rohith8988/autonomous_rc_car/Hardware/Electronics/version_1/RC_Car_Electrical_Diagram.png

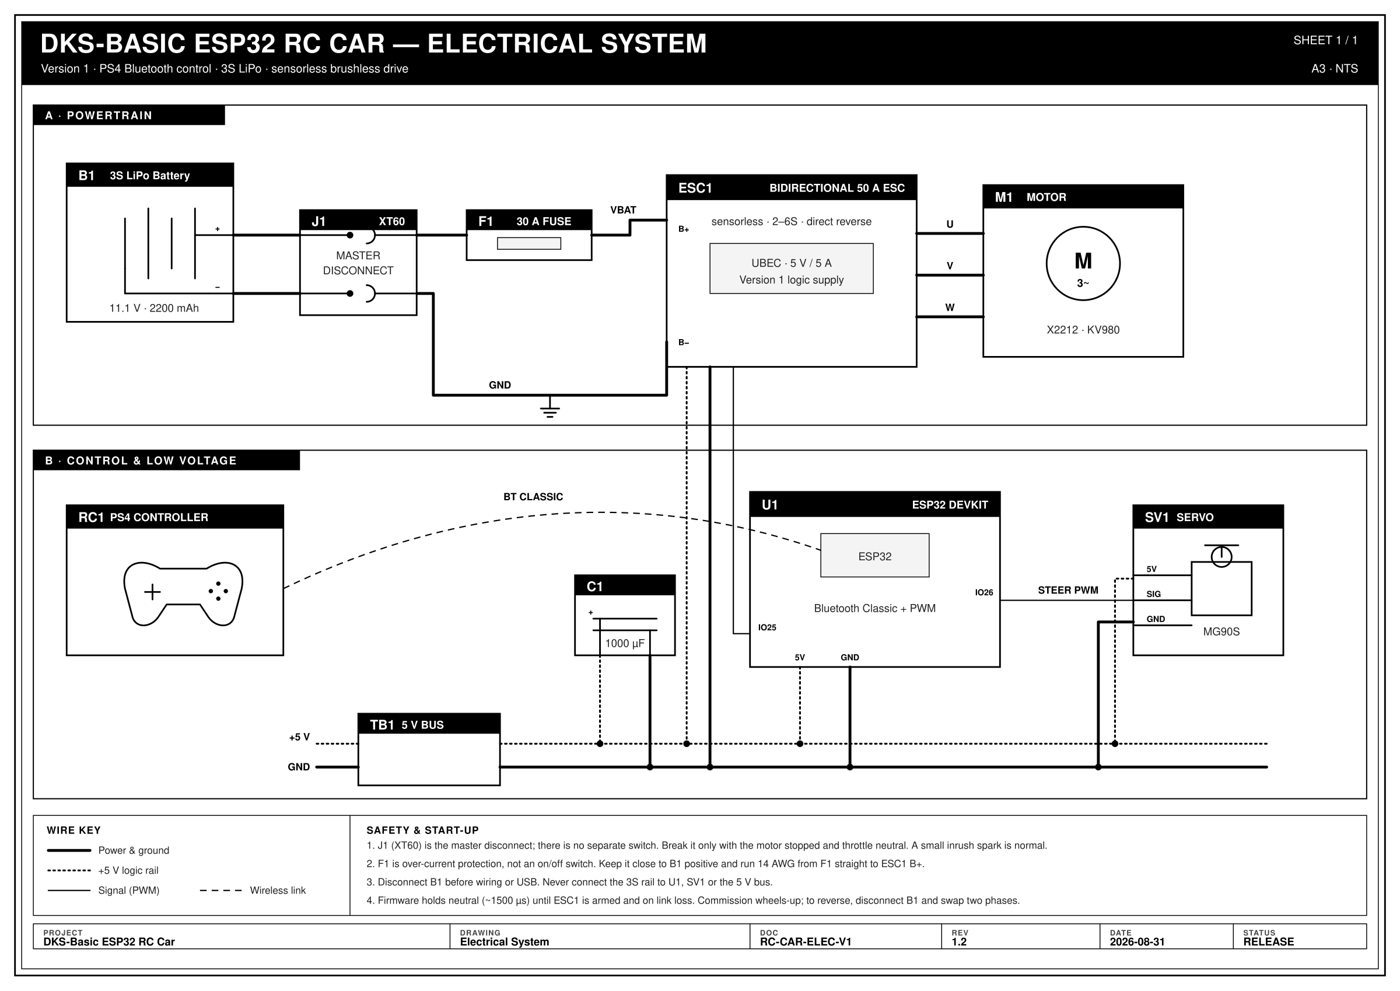
Hardware/Electronics/version_1/RC_Car_Electrical_Diagram.png
