rohith8988/autonomous_rc_car/Hardware/Mechanical/Motor_Specifications/drawing.png

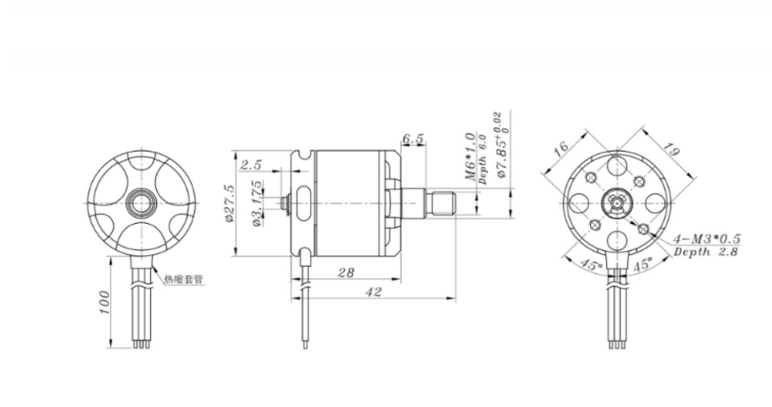
Hardware/Mechanical/Motor_Specifications/drawing.png
