rohith8988/autonomous_rc_car/Hardware/Electronics/version_1/BOM.csv

Reference | Quantity | Part | Specification | Status | Preferred Store | Listed Price INR | Product Link | Price Checked | Notes
B1 | 1 | LiPo battery | Pro-Range 3S 2200 mAh 30C; 11.1 V nominal; XT60 discharge connector | Bought | Robu.in | 1619 | https://robu.in/product-category/3-cell-lipo-11-1v-12-6v/ | 2026-08-27 | 12.6 V maximum when fully charged; exact Robu SKU 23741
F1 | 1 kit | Inline fuse and holder | 30 A ATC/ATO blade fuse; waterproof holder; 12 AWG leads; 10-set kit | Need to buy | Amazon.in | 1700 | https://www.amazon.in/dp/B0BNGP7PQR | 2026-08-27 | Install close to battery positive. Over-current protection only, never an on/off switch. Selected because the Robu holder found was rated only 25 A
ESC1 | 1 | Bidirectional brushless ESC | Robu SKU 1345166; 50 A class; 2-6S; 5 V/5 A UBEC; sensorless | Need to buy | Robu.in | 1270 | https://robu.in/product/bidirectional-50a-2-6s-ubec-5a-5v | 2026-08-27 | Integrated UBEC is the sole 5 V source
M1 | 1 | Brushless motor | SunnySky X2212-13 KV980 CW; sensorless three phase | Bought | Robu.in | N/A | https://robu.in/product/sunny-sky-x-fixed-wing-series-iii-motor-x2212-iii-980kv | 2026-08-27 | Reference link for the owned motor; mounted with the custom cylindrical rear frame
U1 | 1 | ESP32 development board | ESP32-WROOM-32 38-pin board with Bluetooth Classic; 5 V/VIN input | Bought | Robu.in | N/A | https://robu.in/product/esp32-38pin-development-board-wifibluetooth-ultra-low-power-consumption-dual-core/ | 2026-08-27 | Reference link for the owned board; GPIO25 throttle and GPIO26 steering
SV1 | 1 | Steering servo | TowardPro MG90S mini digital servo; 180-degree; 4.8-6 V | Bought | Robu.in | N/A | https://robu.in/product-category/towerpro-servo-motor/ | 2026-08-27 | Reference link for the owned servo; powered at 5 V
C1 | 1 | Electrolytic capacitor | 1000 uF; 16-25 V; radial; low-ESR / low-impedance; 105 C. Preferred sub: Nichicon UHV1C102MPD (16 V). Original UPW1A102MPD6TD (10 V) is out of stock at Robu | Need to buy | Robu.in | Check live price | https://robu.in/product/uhv1c102mpd-nichicon-1000uf-16v-30m%CF%89-%C2%B120-1-089a120hz-plugind10xl16mm-aluminum-electrolytic-capacitors-leaded-rohs/ | 2026-08-27 | 16-25 V preferred over 10 V on the 5 V rail. Mount at the 5 V distribution point; observe polarity. Verify live stock. Alt: Evelta 1000uF 16V https://evelta.com/1000uf-16v-electrolytic-capacitor/ | element14 IN Nichicon UHE1C102MPD1TD https://in.element14.com/nichicon/uhe1c102mpd1td/aluminum-electrolytic-capacitor/dp/1823631 | Mouser Panasonic EEU-FR1C102 https://www.mouser.com/ProductDetail/Panasonic/EEU-FR1C102
TB1 | 2 | Five-way lever connector | WAGO 221-415 (5-conductor, 0.2-4 mm2); one for +5 V and one for GND. 221-414 (4-way) also sufficient | Need to buy | Amazon.in | Check live price | https://www.amazon.in/WAGO-221-415-Lever-Nuts-5-Conductor-Connectors/dp/B07WC2XBMK | 2026-08-27 | Out of stock at Robu. Amazon listing is a box of 25. Separate insulated 5 V and common-ground distribution points. Alt: Flipkart https://www.flipkart.com/wago-221-415-connectors-wire-connector/p/itm1a498ee59abb4 | WAGO India https://www.wago.com/in/installation-terminal-blocks-and-connectors/splicing-connector-with-levers/p/221-415
J1 | 1 | XT60 battery pigtail (master disconnect) | Amass XT60 male with 14 AWG silicone wire, ~15 cm (SafeConnect original is out of stock at Robu) | Need to buy | Quartz Components | Check live price | https://quartzcomponents.com/products/xt60-male-connector-with-14awg-silicone-wire | 2026-08-27 | Master disconnect for the car. SW1 is bypassed, so this is the only way to isolate B1: mate or break it with the motor stopped and throttle neutral, never under load. A small inrush spark on connection is normal as the ESC capacitors charge; fit an anti-spark XT90-S if it becomes significant. Accepts the loss of a quickly reachable emergency cutoff. Mates with the battery XT60 female; confirm polarity with a multimeter before soldering; use genuine Amass not clones. Alt: solder-your-own from an Amass XT60 pair https://robocraze.com/products/xt60-connector-pair using W1R/W1B wire | Amazon.in https://www.amazon.in/Robocraze-XT60-Male-connector-pack/dp/B0DPZDLKY4
J2M-J4M | 3 | Motor phase male connectors | Amass GC3510-M; 3.5 mm gold-plated bullet connectors | Need to buy | Robu.in | Check live price | https://robu.in/product/amass-3-5mm-bullet-male-connector-gc3510-m/ | 2026-08-27 | Buy only if neither the motor nor ESC already includes the required male side. Evelta sells male+female together: https://evelta.com/3-5mm-gold-plated-bullet-male-female-banana-connector/ | RC Mumbai 5-pair: https://rcmumbai.com/bullet-connector-3-5mm.html
J2F-J4F | 3 | Motor phase female connectors | Amass GC3510-F; 3.5 mm gold-plated bullet connectors | Need to buy | Robu.in | Check live price | https://robu.in/product/amass-3-5mm-bullet-female-connector-gc3510-f/ | 2026-08-27 | Buy only if neither the motor nor ESC already includes the required female side; fully cover with heat-shrink. Evelta male+female set: https://evelta.com/3-5mm-gold-plated-bullet-male-female-banana-connector/
W1R | 1 m | High-current red wire | 14 AWG flexible stranded silicone wire; red | Need to buy | Robu.in | 66 | https://robu.in/?s=R179509&post_type=product | 2026-08-27 | Battery positive harness: B1 to F1, then 14 AWG from F1 straight to ESC1 B+
W1B | 1 m | High-current black wire | 14 AWG flexible stranded silicone wire; black | Need to buy | Robu.in | 56 | https://robu.in/?s=R179508&post_type=product | 2026-08-27 | Battery-negative and high-current return wiring
W2 | 1 m | Low-voltage three-core wire | 22 AWG flexible silicone cable; red black and green cores; Robu SKU R257312 | Need to buy | Robu.in | 69 | https://robu.in/?s=R257312&post_type=product | 2026-08-27 | For short 5 V ground and signal harnesses
H1 | 1 kit | Heat-shrink tubing | 328-piece flame-retardant polyolefin assortment; 2:1 shrink ratio; 1-14 mm sizes | Need to buy | Robu.in | 159 | https://robu.in/?s=R256576&post_type=product | 2026-08-27 | No conductive connector or solder joint may remain exposed
H2 | 1 pack | Cable ties | Nylon cable ties; 100 mm x 2.5 mm; pack of 100 | Need to buy | Robu.in | 30 | https://robu.in/product-category/cable-ties/ | 2026-08-27 | Use for harness bundling and strain relief
H3 | 1 pack | Adhesive cable-tie mounts | Immech nylon self-adhesive mounts; 19 x 19 mm; pack of 100 | Need to buy | Amazon.in | 194 | https://www.amazon.in/dp/B091GG934H | 2026-08-27 | Clean the mounting surface with isopropyl alcohol before applying
