rohith8988/autonomous_rc_car/Hardware/Mechanical/RC_Car_Assembly.FCStd

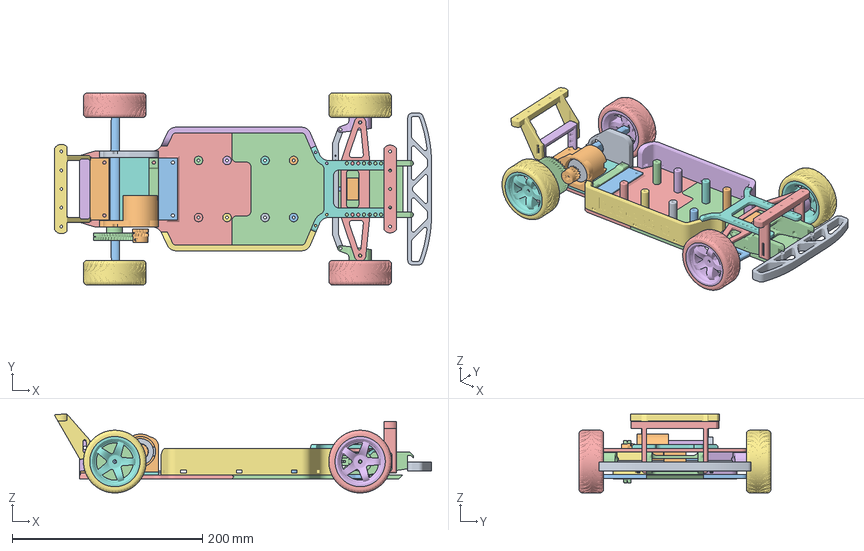
[picture p6: CAD file, 2026-09-17]
Hardware/Mechanical/RC_Car_Assembly.FCStd
396.5 x 202.0 x 83.0 mm
motor_link_body
servo_link_body
servo_horn_body
Standoff_1
Standoff_2
Standoff_3
Standoff_4
Standoff_5
Standoff_6
Standoff_7
Standoff_8
DKS-Basic_DukeDoks_Chassis-1
DKS-Basic_DukeDoks_Chassis-2_A
DKS-Basic_DukeDoks_Body_L
DKS-Basic_DukeDoks_Body_R
DKS-Basic_DukeDoks_Front-Bars
DKS-Basic_DukeDoks_Bumper
DKS-Basic_DukeDoks_Rear-Flex-1
DKS-Basic_DukeDoks_Rear-Flex-2
DKS-Basic_DukeDoks_Clamp
DKS-Basic_DukeDoks_Front-Case-Holder
DKS-Basic_DukeDoks_Clamp-Case-Holder
DKS-Basic_DukeDoks_Rear-Case-Holder
DKS-Basic_DukeDoks_Rear-Frame-Lower
DKS-Basic_DukeDoks_Rear-Frame_L
X2212_Rear_Frame_A_OnePiece
DKS-Basic_DukeDoks_Front-Bars-Lower
DKS-Basic_DukeDoks_A_Front-Frame
DKS-Basic_DukeDoks_A_Front-Bars-Upper
DKS-Basic_DukeDoks_Wheel-Hub_mirrored
DKS-Basic_DukeDoks_Basic-Wheel-01-Tire
DKS-Basic_DukeDoks_Basic-Wheel-01-Wheel
DKS-Basic_DukeDoks_Wheel-Axis
DKS-Basic_DukeDoks_Wheel-Axis001
DKS-Basic_DukeDoks_Wheel-Axis-Nut
DKS-Basic_DukeDoks_Wheel-Hub
DKS-Basic_DukeDoks_Basic-Wheel-01-Tire001
DKS-Basic_DukeDoks_Basic-Wheel-01-Wheel001
DKS-Basic_DukeDoks_Wheel-Axis_mirrored
DKS-Basic_DukeDoks_Wheel-Axis_mirrored001
DKS-Basic_DukeDoks_Wheel-Axis-Nut001
X2212_Smooth_Herringbone_Gear_1_14T_M3_Clamp
DKS-Basic_DukeDoks_Rear-Axis
X2212_Smooth_Herringbone_Gear_2_42T
DKS-Basic_DukeDoks_Basic-Wheel-01-Tire002
DKS-Basic_DukeDoks_Basic-Wheel-01-Wheel002
DKS-Basic_DukeDoks_Basic-Wheel-01-Tire003
DKS-Basic_DukeDoks_Basic-Wheel-01-Wheel003
DKS-Basic_DukeDoks_A_Steering
