rohith8988/autonomous_rc_car/Hardware/Mechanical/Deck/Sensor_Deck.stl

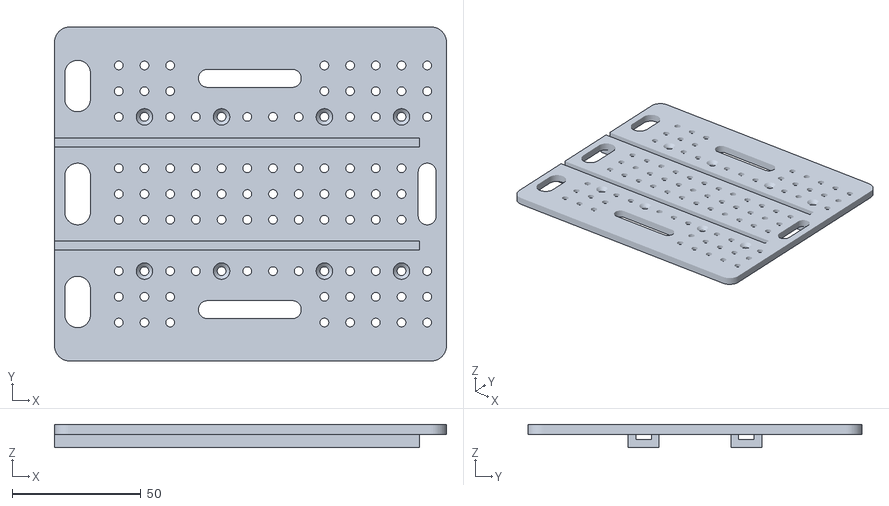
[picture p7: CAD file, 2026-09-17]
Hardware/Mechanical/Deck/Sensor_Deck.stl
152.5 x 130.0 x 9.00
