rohith8988/autonomous_rc_car/Hardware/Mechanical/DKS_Basic_Chassis/STL/DKS-Basic_DukeDoks_Bumper.stl

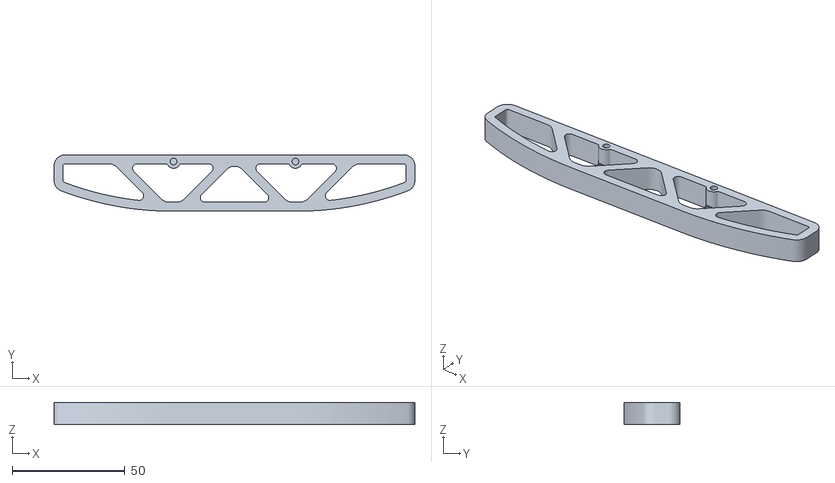
[picture p8: CAD file, 2026-08-24]
Hardware/Mechanical/DKS_Basic_Chassis/STL/DKS-Basic_DukeDoks_Bumper.stl
160.0 x 25.0 x 9.90
