rohith8988/autonomous_rc_car/Hardware/Mechanical/DKS_Basic_Chassis/STL/Front Frame A/DKS-Basic_DukeDoks_A_Steering.stl

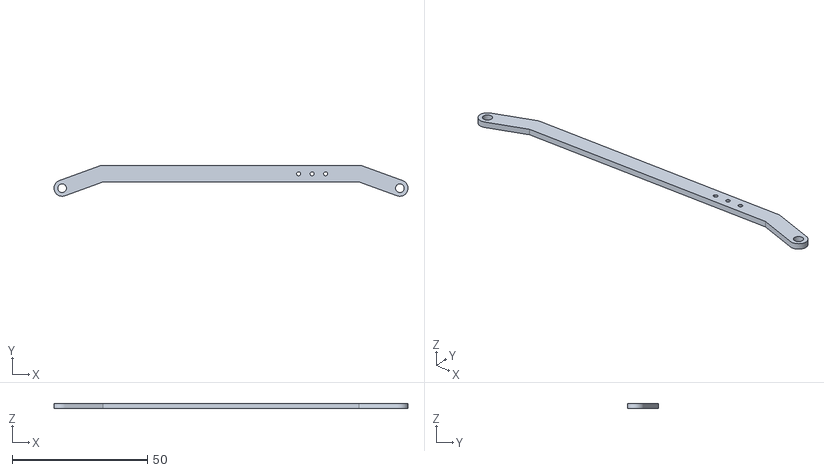
[picture p9: CAD file, 2026-08-24]
Hardware/Mechanical/DKS_Basic_Chassis/STL/Front Frame A/DKS-Basic_DukeDoks_A_Steering.stl
131.0 x 11.3 x 2.00
