rohith8988/autonomous_rc_car/Hardware/Mechanical/DKS_Basic_Chassis/STL/Front Frame B/DKS-Basic_DukeDoks_B_Front-Bars-Upper_L.stl

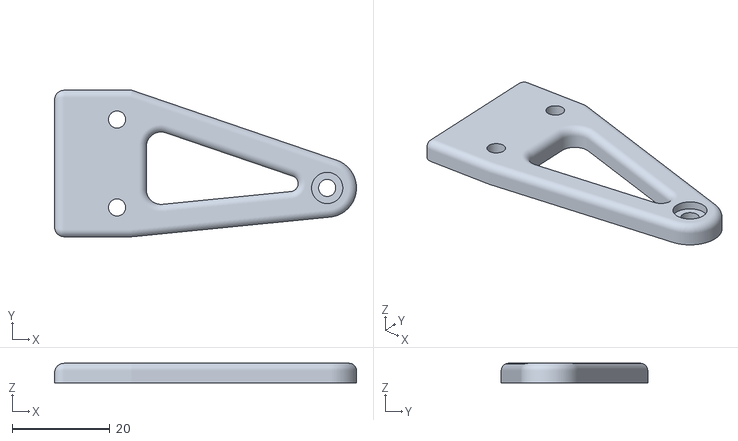
[picture p10: CAD file, 2026-08-24]
Hardware/Mechanical/DKS_Basic_Chassis/STL/Front Frame B/DKS-Basic_DukeDoks_B_Front-Bars-Upper_L.stl
61.8 x 30.0 x 4.00
