rohith8988/autonomous_rc_car/Hardware/Mechanical/Custom_Motor_Mount/output/X2212_Rear_Frame_A_OnePiece.stl

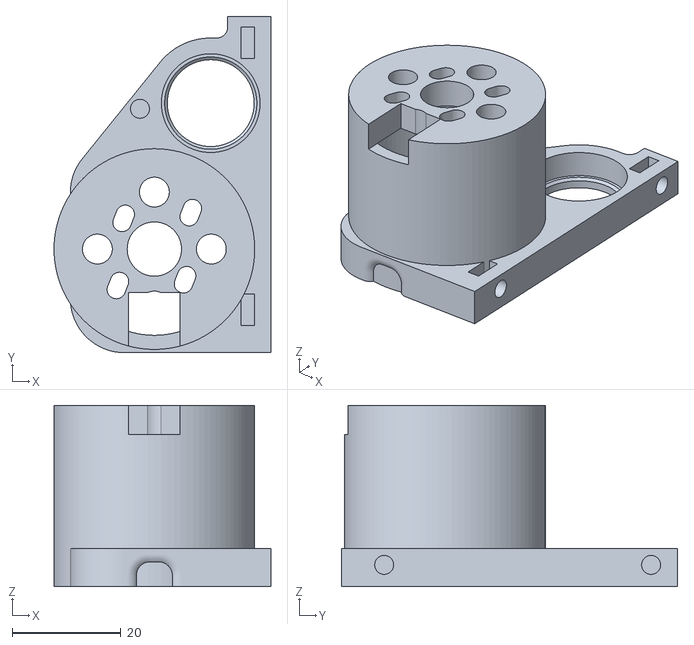
[picture p11: CAD file, 2026-08-24]
Hardware/Mechanical/Custom_Motor_Mount/output/X2212_Rear_Frame_A_OnePiece.stl
40.0 x 62.0 x 33.4
