rohith8988/autonomous_rc_car/Hardware/Mechanical/DKS_Basic_Chassis/STL/DKS-Basic_DukeDoks_Gear-2.stl

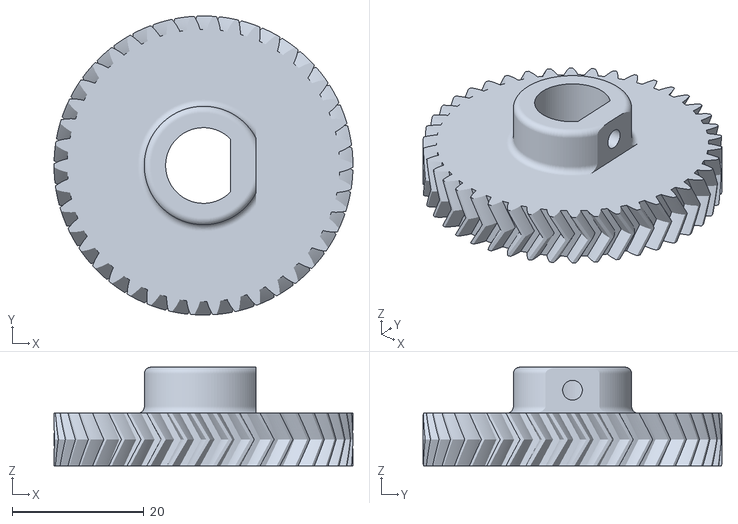
[picture p12: CAD file, 2026-08-24]
Hardware/Mechanical/DKS_Basic_Chassis/STL/DKS-Basic_DukeDoks_Gear-2.stl
45.4 x 45.4 x 15.0
