rohith8988/autonomous_rc_car/Hardware/Mechanical/DKS_Basic_Chassis/STL/Front Frame A/DKS-Basic_DukeDoks_A_Front-Bars-Upper.stl

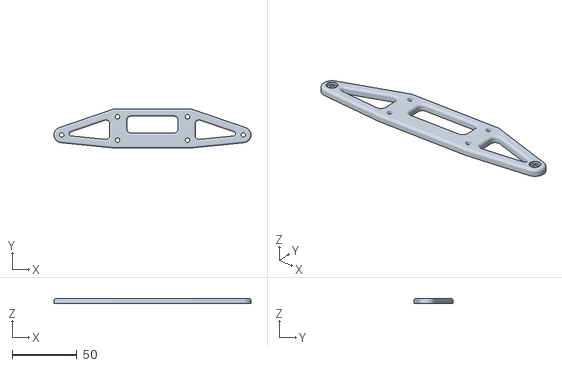
[picture p13: CAD file, 2026-08-24]
Hardware/Mechanical/DKS_Basic_Chassis/STL/Front Frame A/DKS-Basic_DukeDoks_A_Front-Bars-Upper.stl
152.0 x 30.0 x 4.00
