rohith8988/autonomous_rc_car/Hardware/Mechanical/DKS_Basic_Chassis/STL/Front Frame B/DKS-Basic_DukeDoks_B_Steering_L.stl

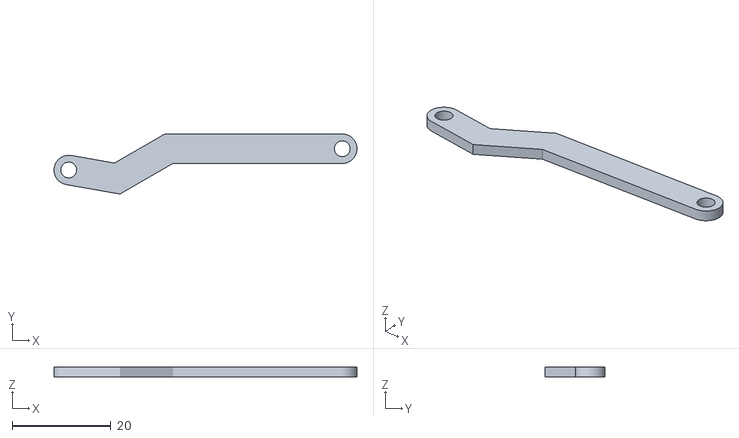
[picture p14: CAD file, 2026-08-24]
Hardware/Mechanical/DKS_Basic_Chassis/STL/Front Frame B/DKS-Basic_DukeDoks_B_Steering_L.stl
61.5 x 12.2 x 2.00
