rohith8988/autonomous_rc_car/Hardware/Mechanical/DKS_Basic_Chassis/STL/Wheels/DKS-Basic_DukeDoks_Basic-Wheel-01-Wheel-with-supports.stl

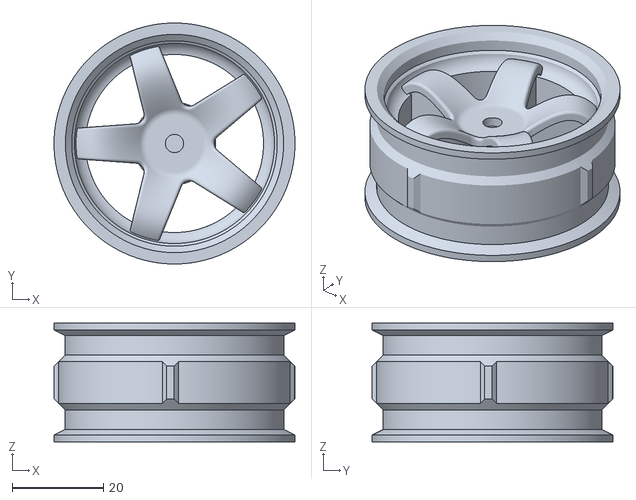
[picture p15: CAD file, 2026-08-24]
Hardware/Mechanical/DKS_Basic_Chassis/STL/Wheels/DKS-Basic_DukeDoks_Basic-Wheel-01-Wheel-with-supports.stl
52.8 x 52.8 x 26.0
