rohith8988/autonomous_rc_car/Hardware/Mechanical/Custom_Motor_Mount/output/X2212_Boss_Fit_Gauge.stl

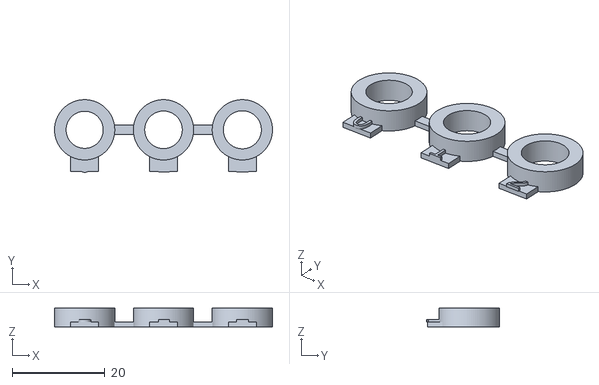
[picture p16: CAD file, 2026-08-24]
Hardware/Mechanical/Custom_Motor_Mount/output/X2212_Boss_Fit_Gauge.stl
47.0 x 15.7 x 4.00
