rohith8988/autonomous_rc_car/Hardware/Mechanical/Deck/Standoff_28mm_print.stl

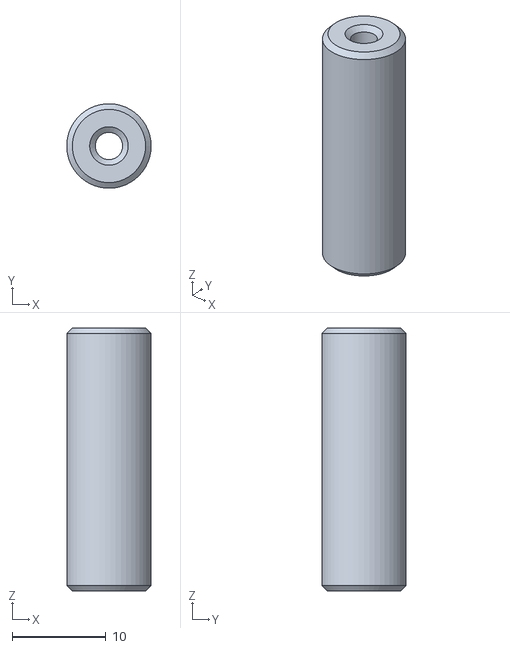
[picture p17: CAD file, 2026-09-17]
Hardware/Mechanical/Deck/Standoff_28mm_print.stl
8.99 x 9.00 x 28.0
