rohith8988/autonomous_rc_car/Hardware/Mechanical/DKS_Basic_Chassis/STL/DKS-Basic_DukeDoks_Chassis-1.stl

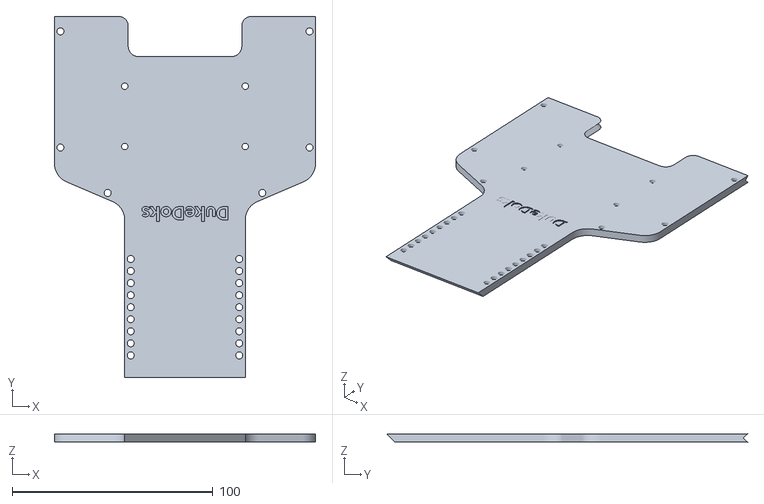
[picture p18: CAD file, 2026-08-24]
Hardware/Mechanical/DKS_Basic_Chassis/STL/DKS-Basic_DukeDoks_Chassis-1.stl
130.0 x 179.7 x 4.00
