rohith8988/autonomous_rc_car/Hardware/Mechanical/DKS_Basic_Chassis/STL/Front Frame B/DKS-Basic_DukeDoks_B_Servo-Arm.stl

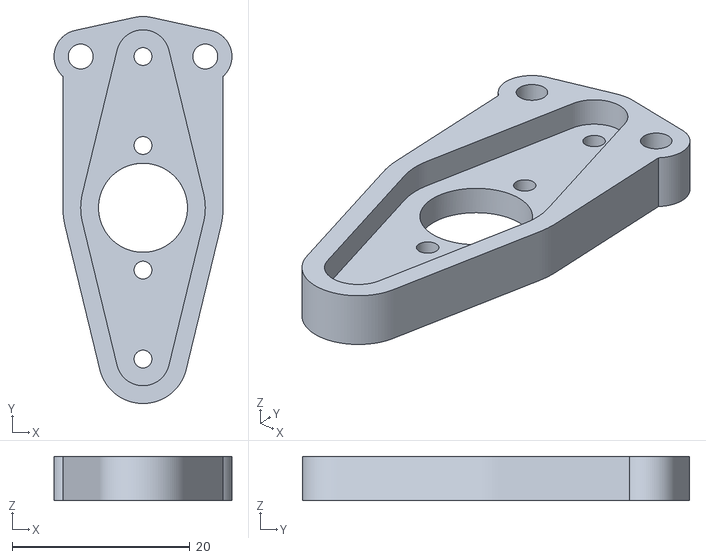
[picture p19: CAD file, 2026-08-24]
Hardware/Mechanical/DKS_Basic_Chassis/STL/Front Frame B/DKS-Basic_DukeDoks_B_Servo-Arm.stl
20.0 x 43.5 x 5.00
