rohith8988/autonomous_rc_car/Software/rc_car_description/meshes/DKS-Basic_DukeDoks_Chassis-2_A.stl

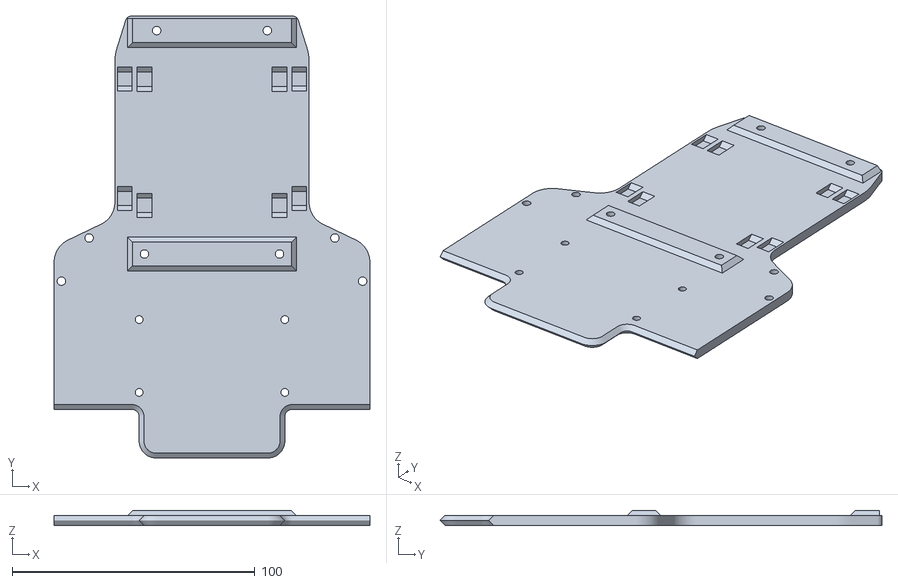
[picture p20: CAD file, 2026-09-02]
Software/rc_car_description/meshes/DKS-Basic_DukeDoks_Chassis-2_A.stl
130.0 x 182.0 x 6.00
