rohith8988/autonomous_rc_car/Hardware/Mechanical/Custom_Motor_Mount/output/X2212_Motor_Pattern_Test.stl

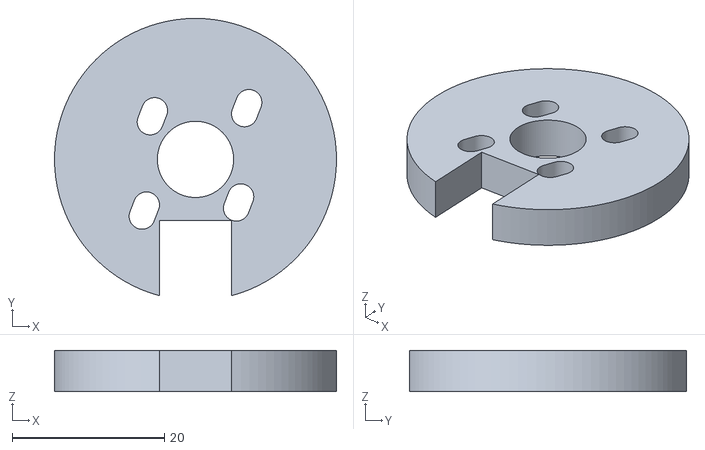
[picture p21: CAD file, 2026-08-24]
Hardware/Mechanical/Custom_Motor_Mount/output/X2212_Motor_Pattern_Test.stl
37.0 x 36.4 x 5.40
