rohith8988/autonomous_rc_car/Hardware/Mechanical/DKS_Basic_Chassis/STL/DKS-Basic_DukeDoks_Wheel-Adapter.stl

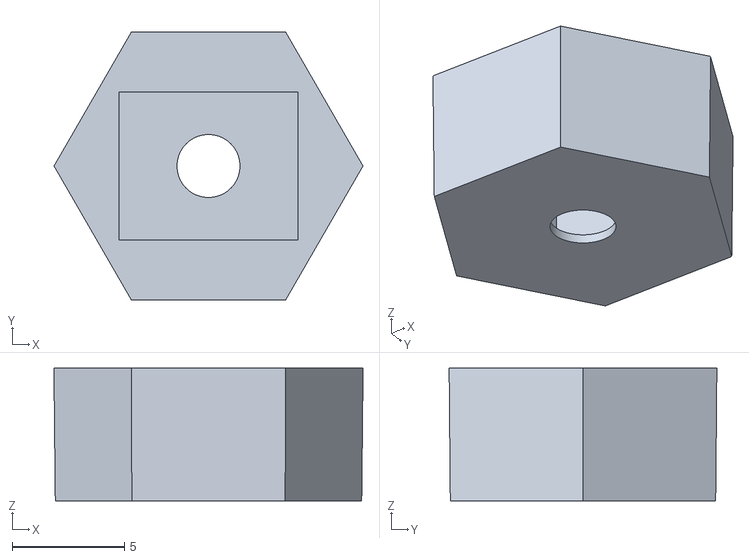
[picture p22: CAD file, 2026-08-24]
Hardware/Mechanical/DKS_Basic_Chassis/STL/DKS-Basic_DukeDoks_Wheel-Adapter.stl
13.7 x 11.9 x 5.90
