rohith8988/autonomous_rc_car/Software/rc_car_description/meshes/DKS-Basic_DukeDoks_Body_R.stl

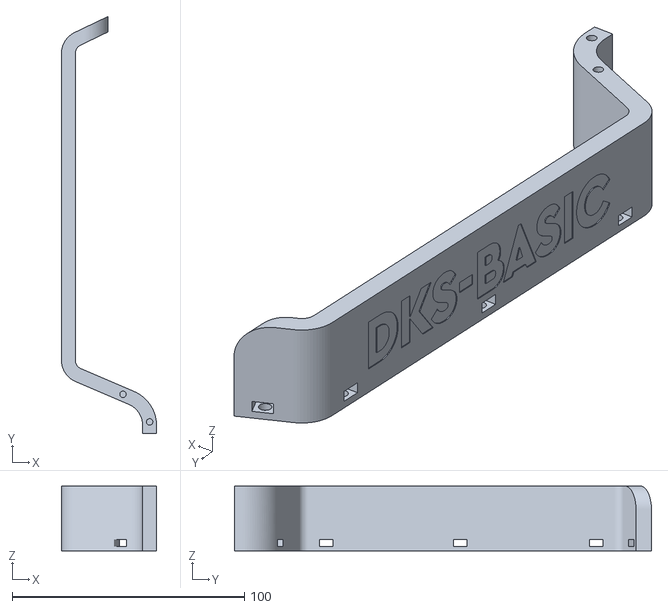
[picture p23: CAD file, 2026-09-02]
Software/rc_car_description/meshes/DKS-Basic_DukeDoks_Body_R.stl
41.0 x 179.6 x 28.0
