rohith8988/autonomous_rc_car/Hardware/Mechanical/DKS_Basic_Chassis/STL/DKS-Basic_DukeDoks_Gear-1_B.stl

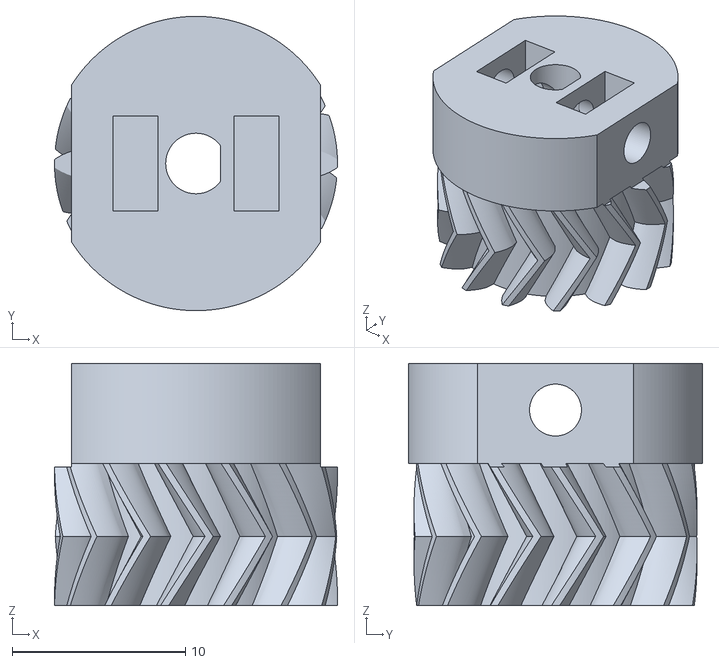
[picture p24: CAD file, 2026-08-24]
Hardware/Mechanical/DKS_Basic_Chassis/STL/DKS-Basic_DukeDoks_Gear-1_B.stl
16.3 x 17.0 x 14.0
