rohith8988/autonomous_rc_car/Software/rc_car_description/meshes/DKS-Basic_DukeDoks_Wheel-Hub_mirrored.stl

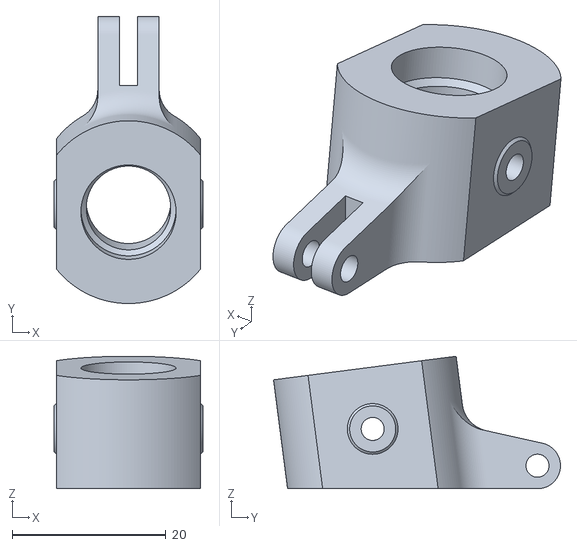
[picture p25: CAD file, 2026-09-02]
Software/rc_car_description/meshes/DKS-Basic_DukeDoks_Wheel-Hub_mirrored.stl
19.4 x 37.4 x 17.3
