rohith8988/autonomous_rc_car/Hardware/Mechanical/DKS_Basic_Chassis/STL/Front Frame B/DKS-Basic_DukeDoks_B_Front-Frame.stl

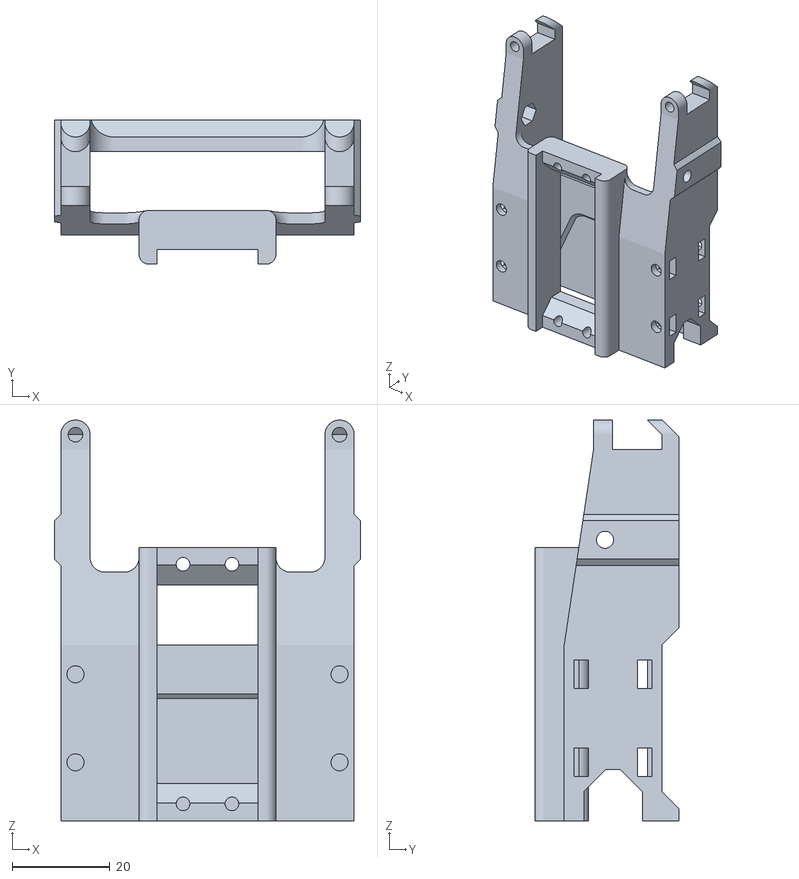
[picture p27: CAD file, 2026-08-24]
Hardware/Mechanical/DKS_Basic_Chassis/STL/Front Frame B/DKS-Basic_DukeDoks_B_Front-Frame.stl
62.6 x 29.5 x 82.0
