rohith8988/autonomous_rc_car/Software/rc_car_description/meshes/DKS-Basic_DukeDoks_Wheel-Axis.stl

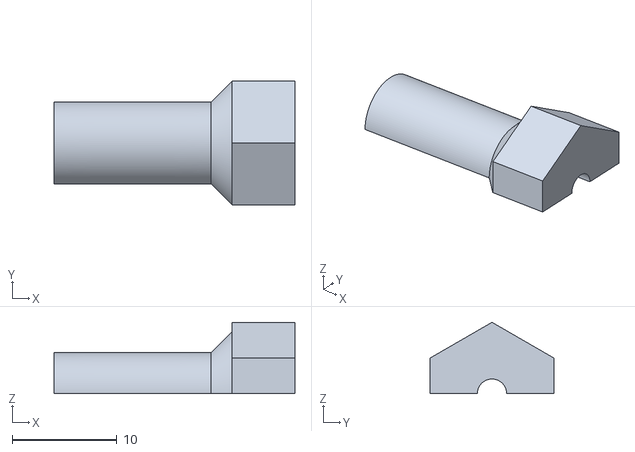
[picture p28: CAD file, 2026-09-02]
Software/rc_car_description/meshes/DKS-Basic_DukeDoks_Wheel-Axis.stl
23.0 x 11.8 x 6.81
