rohith8988/autonomous_rc_car/Software/rc_car_description/meshes/X2212_Smooth_Herringbone_Gear_1_14T_M3_Clamp.stl

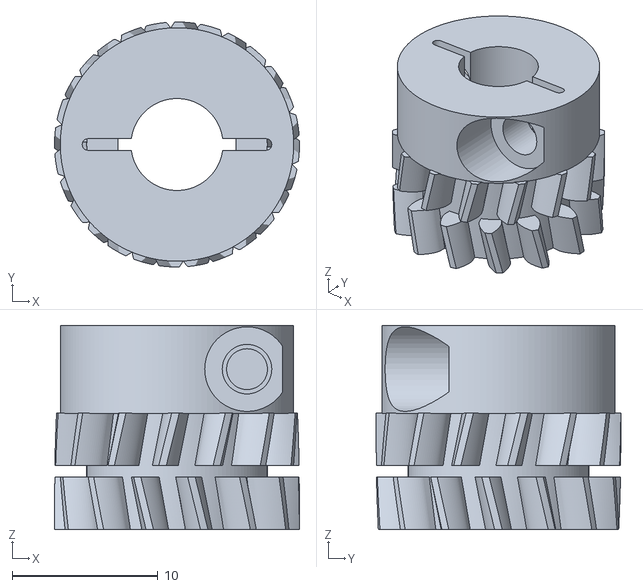
[picture p36: CAD file, 2026-09-02]
Software/rc_car_description/meshes/X2212_Smooth_Herringbone_Gear_1_14T_M3_Clamp.stl
16.8 x 16.8 x 14.0
