rohith8988/autonomous_rc_car/Software/rc_car_description/meshes/DKS-Basic_DukeDoks_Front-Bars-Lower.stl

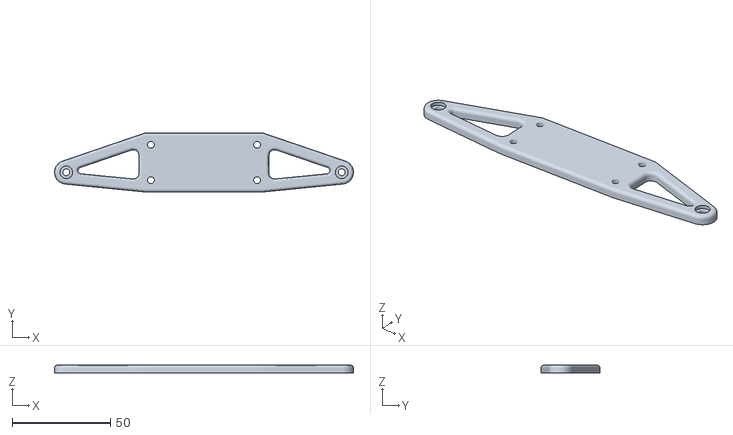
[picture p38: CAD file, 2026-08-24]
Software/rc_car_description/meshes/DKS-Basic_DukeDoks_Front-Bars-Lower.stl
152.0 x 30.0 x 4.00
