rohith8988/autonomous_rc_car/Software/rc_car_description/meshes/DKS-Basic_DukeDoks_Rear-Case-Holder.stl

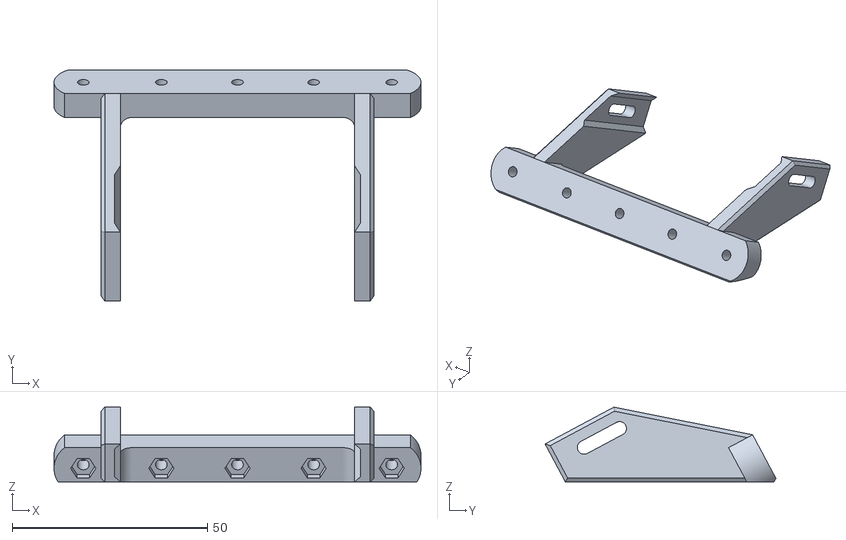
[picture p39: CAD file, 2026-08-24]
Software/rc_car_description/meshes/DKS-Basic_DukeDoks_Rear-Case-Holder.stl
94.0 x 59.2 x 19.1
