rohith8988/autonomous_rc_car/Software/rc_car_description/meshes/DKS-Basic_DukeDoks_Front-Case-Holder.stl

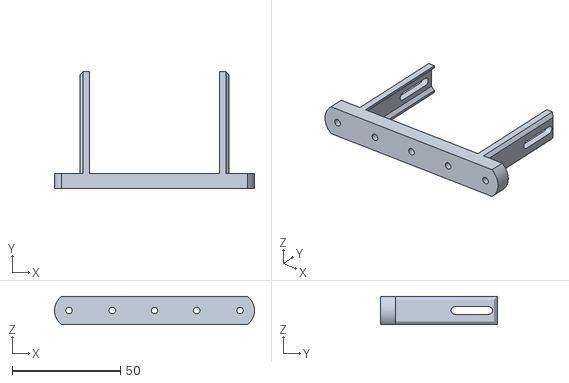
[picture p40: CAD file, 2026-08-24]
Software/rc_car_description/meshes/DKS-Basic_DukeDoks_Front-Case-Holder.stl
92.4 x 54.0 x 13.0
