rohith8988/autonomous_rc_car/Software/rc_car_description/meshes/DKS-Basic_DukeDoks_Rear-Frame_L.stl

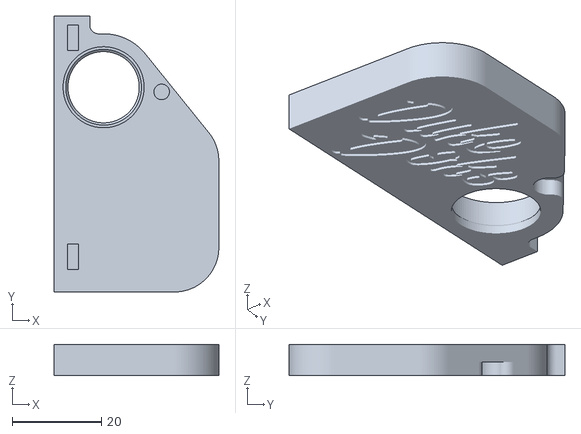
[picture p41: CAD file, 2026-08-24]
Software/rc_car_description/meshes/DKS-Basic_DukeDoks_Rear-Frame_L.stl
37.0 x 62.0 x 7.00
