rohith8988/autonomous_rc_car/Software/rc_car_description/meshes/DKS-Basic_DukeDoks_Rear-Axis.stl

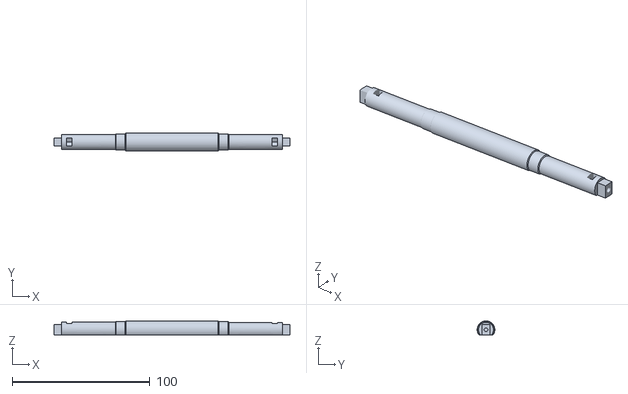
[picture p42: CAD file, 2026-08-24]
Software/rc_car_description/meshes/DKS-Basic_DukeDoks_Rear-Axis.stl
171.2 x 12.8 x 10.3
