rohith8988/autonomous_rc_car/Software/rc_car_description/meshes/DKS-Basic_DukeDoks_Basic-Wheel-01-Wheel.stl

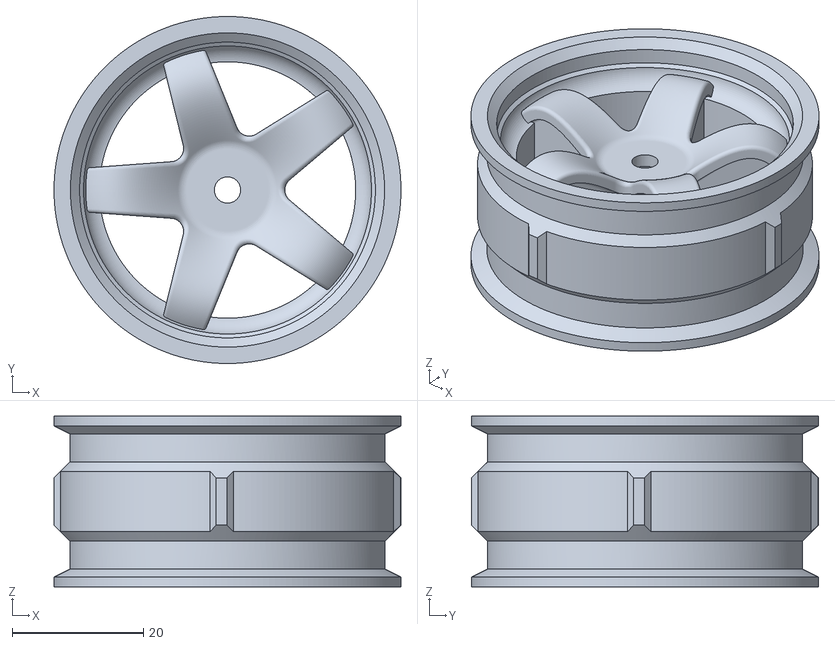
[picture p43: CAD file, 2026-08-24]
Software/rc_car_description/meshes/DKS-Basic_DukeDoks_Basic-Wheel-01-Wheel.stl
52.8 x 52.8 x 26.0
