rohith8988/autonomous_rc_car/Software/rc_car_description/meshes/DKS-Basic_DukeDoks_Clamp-Case-Holder.stl

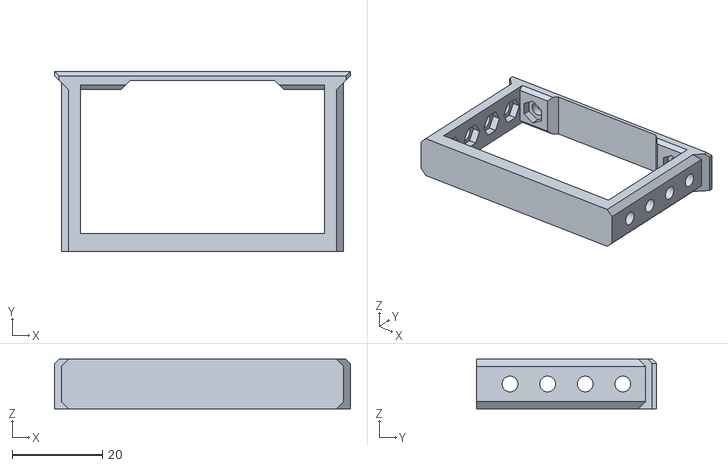
[picture p44: CAD file, 2026-08-24]
Software/rc_car_description/meshes/DKS-Basic_DukeDoks_Clamp-Case-Holder.stl
65.6 x 40.0 x 11.0
