rohith8988/autonomous_rc_car/Software/rc_car_description/meshes/DKS-Basic_DukeDoks_Basic-Wheel-01-Tire.stl

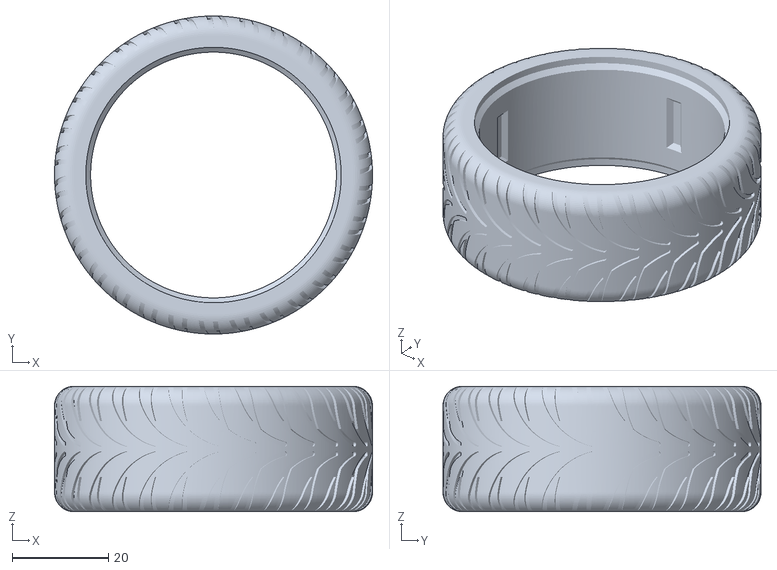
[picture p45: CAD file, 2026-08-24]
Software/rc_car_description/meshes/DKS-Basic_DukeDoks_Basic-Wheel-01-Tire.stl
66.0 x 66.0 x 26.0
