rohith8988/autonomous_rc_car/Software/rc_car_description/meshes/DKS-Basic_DukeDoks_A_Front-Frame.stl

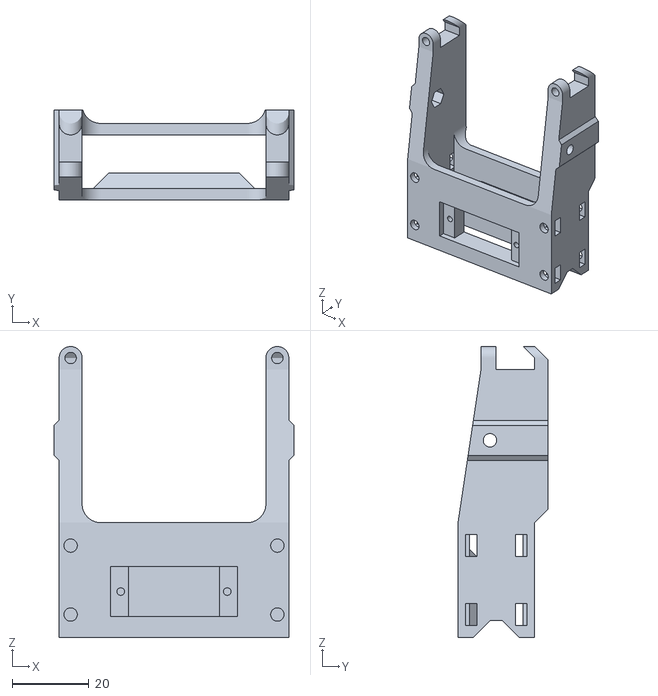
[picture p46: CAD file, 2026-08-24]
Software/rc_car_description/meshes/DKS-Basic_DukeDoks_A_Front-Frame.stl
62.6 x 23.5 x 76.0
