rohith8988/autonomous_rc_car/(list of files, cad)

Other CAD files:
Hardware/Mechanical/Deck/Sensor_Deck_print.stl
Software/rc_car_description/meshes/X2212_Smooth_Herringbone_Gear_2_42T.stl
Hardware/Mechanical/DKS_Basic_Chassis/STL/Front Frame B/DKS-Basic_DukeDoks_B_Front-Bars-Upper_R.stl
Hardware/Mechanical/DKS_Basic_Chassis/STL/Front Frame B/DKS-Basic_DukeDoks_B_Steering_R.stl
Software/rc_car_description/meshes/DKS-Basic_DukeDoks_A_Steering.stl
Hardware/Mechanical/DKS_Basic_Chassis/STL/DKS-Basic_DukeDoks_Body_L.stl
Software/rc_car_description/meshes/DKS-Basic_DukeDoks_Bumper.stl
Software/rc_car_description/meshes/DKS-Basic_DukeDoks_A_Front-Bars-Upper.stl
Software/rc_car_description/meshes/DKS-Basic_DukeDoks_Chassis-1.stl
Software/rc_car_description/meshes/DKS-Basic_DukeDoks_Wheel-Axis_mirrored.stl
Software/rc_car_description/meshes/DKS-Basic_DukeDoks_Rear-Flex-2.stl
Hardware/Mechanical/DKS_Basic_Chassis/STL/DKS-Basic_DukeDoks_Body_R.stl
Software/rc_car_description/meshes/X2212_Rear_Frame_A_OnePiece.stl
Hardware/Mechanical/DKS_Basic_Chassis/STL/DKS-Basic_DukeDoks_Chassis-2_A.stl
Software/rc_car_description/meshes/DKS-Basic_DukeDoks_Front-Bars.stl
Software/rc_car_description/meshes/DKS-Basic_DukeDoks_Clamp.stl
Software/rc_car_description/meshes/DKS-Basic_DukeDoks_Rear-Frame-Lower.stl
Hardware/Mechanical/DKS_Basic_Chassis/STL/DKS-Basic_DukeDoks_Wheel-Axis.stl
Software/rc_car_description/meshes/DKS-Basic_DukeDoks_Body_L.stl
Hardware/Mechanical/DKS_Basic_Chassis/STL/DKS-Basic_DukeDoks_Rear-Flex-1.stl
Software/rc_car_description/meshes/DKS-Basic_DukeDoks_Rear-Flex-1.stl
Software/rc_car_description/meshes/DKS-Basic_DukeDoks_Wheel-Hub.stl
Hardware/Mechanical/Custom_Motor_Mount/output/X2212_Gear_1_A_M3_Setscrew.stl
Hardware/Mechanical/DKS_Basic_Chassis/STL/Wheels/DKS-Basic_DukeDoks_Basic-Wheel-01-Nut.stl
Software/rc_car_description/meshes/DKS-Basic_DukeDoks_Wheel-Axis-Nut.stl
custom_motor_mount/output/X2212_M6_Nut_Fit_Gauge.stl
