rohith8988/autonomous_rc_car/(commit log)

2026-08-25 addded new gear designs and also updated the motor mount
    [X2212_Gear_1_A.stl, X2212_M6_Nut_Fit_Gauge.stl, X2212_Rear_Frame_A_OnePiece.scad, X2212_Smooth_Gear_Sets.scad, X2212_Smooth_Herringbone_Gear_1_14T.stl, X2212_Smooth_Herringbone_Gear_2_42T.stl, X2212_Smooth_Spur_Gear_1_14T.stl, X2212_Smooth_Spur_Gear_2_42T.stl]
2026-08-27 organised struct , added electrical diagram and BOM V1
    [BOM.csv, DKS-Basic_DukeDoks_A_Front-Bars-Upper.stl, DKS-Basic_DukeDoks_A_Front-Frame.stl, DKS-Basic_DukeDoks_A_Steering.stl, DKS-Basic_DukeDoks_B_Front-Bars-Upper_L.stl, DKS-Basic_DukeDoks_B_Front-Bars-Upper_R.stl, DKS-Basic_DukeDoks_B_Front-Frame.stl, DKS-Basic_DukeDoks_B_Servo-Arm.stl]
2026-09-02 added the software and and electronics till now
    [BOM.csv, DKS-Basic_DukeDoks_A_Front-Bars-Upper.stl, DKS-Basic_DukeDoks_A_Front-Frame.stl, DKS-Basic_DukeDoks_A_Steering.stl, DKS-Basic_DukeDoks_Basic-Wheel-01-Tire.stl, DKS-Basic_DukeDoks_Basic-Wheel-01-Wheel.stl, DKS-Basic_DukeDoks_Body_L.stl, DKS-Basic_DukeDoks_Body_R.stl]
2026-09-17 added deck, removed redundant files, upodated urdf, added cad file
    [ESP32_Body_Mount.scad, ESP32_Body_Mount.stl, ESP32_Body_Mount_Fit_Gauge.stl, RC_Car_Assembly.FCStd, Sensor_Deck.stl, Sensor_Deck_print.stl, Standoff_28mm_print.stl, X2212_Gear_1_A.stl]
